bcrepeauac/nRF24L01_USB/README.md

# nRF24L01_USB
nRF24L01 adapter board for a computer.
