bcrepeauac/nRF24L01_USB/Rev -/Board Files/WirelessTransceiverUSB_Rev-.pdf

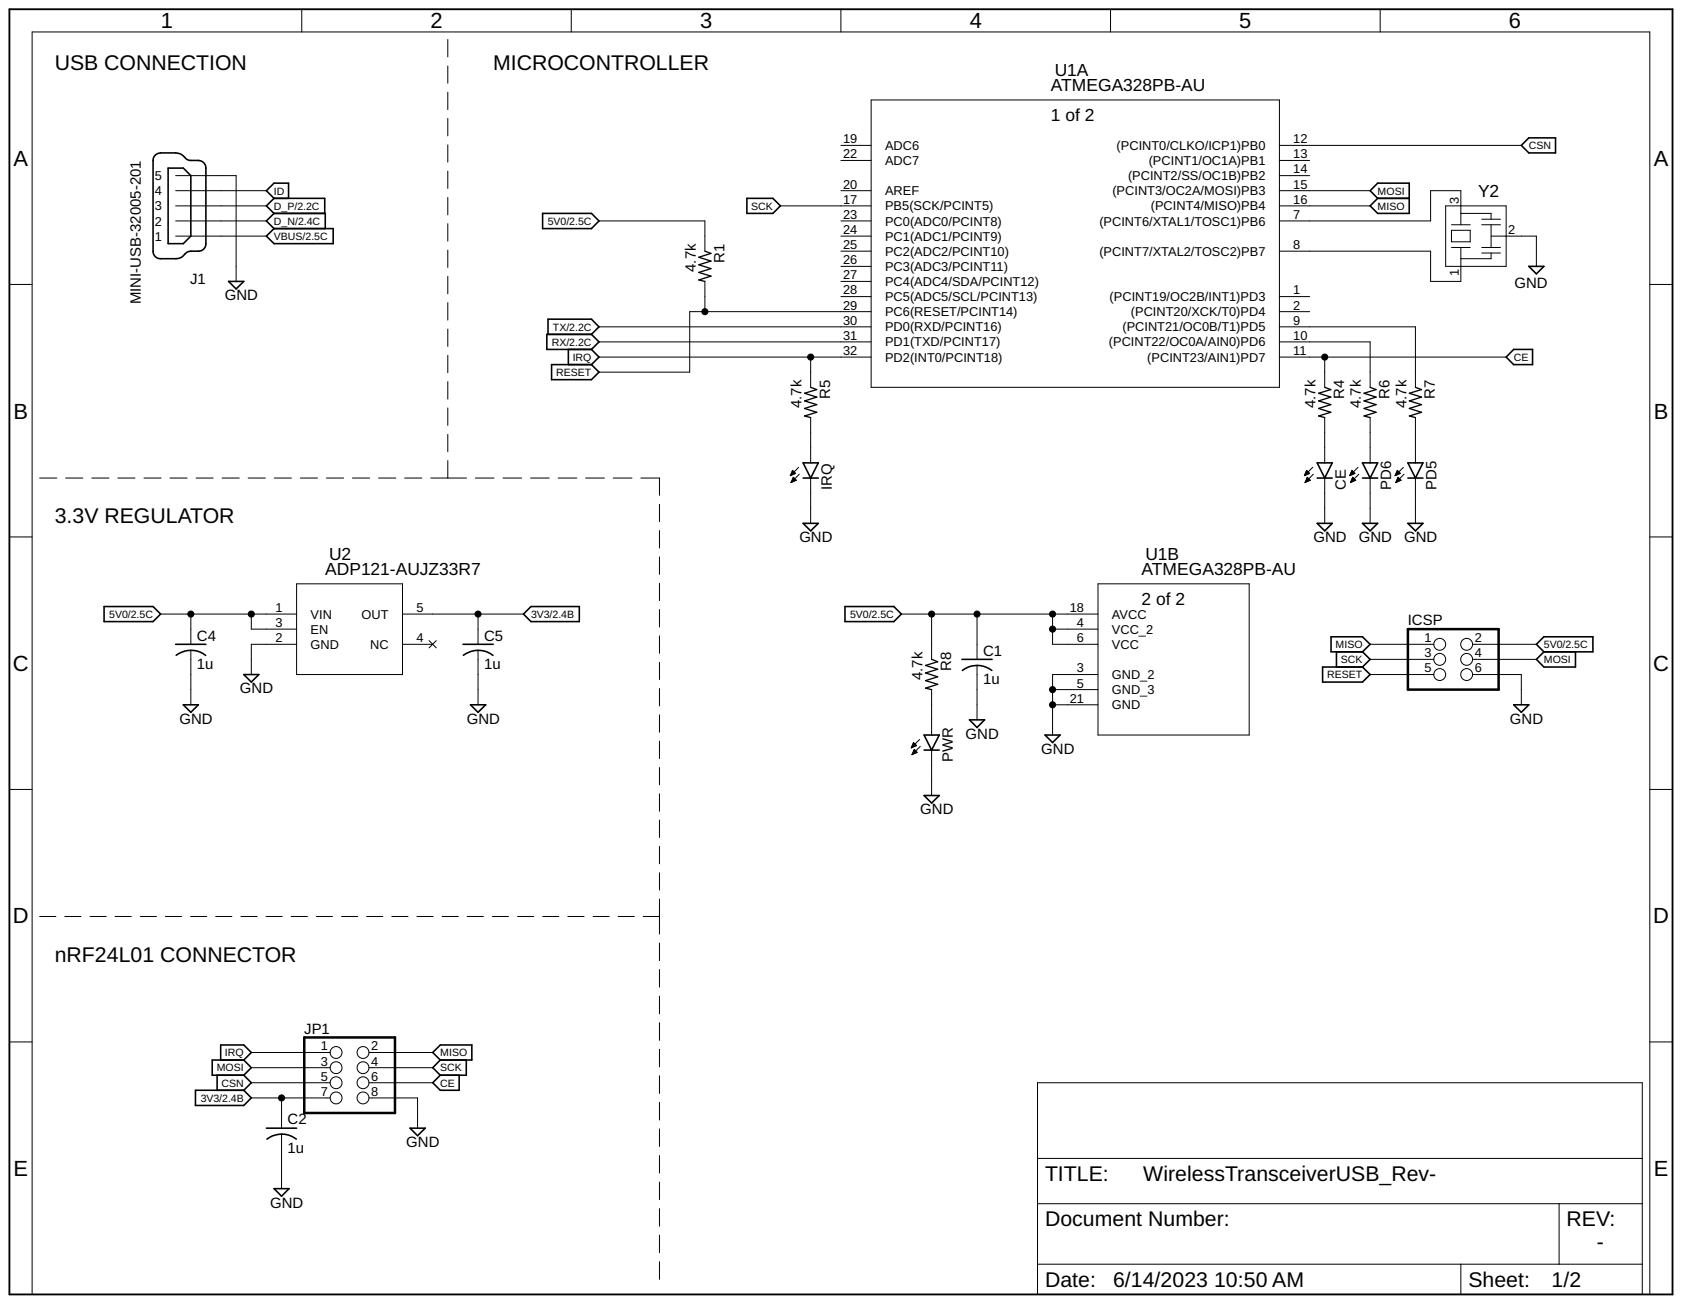
[picture p1: page 1]

ATMEGA328PB-AU

Document Number: | REV: -

Date: 6/14/2023 10:50 AM | Sheet: 1/2

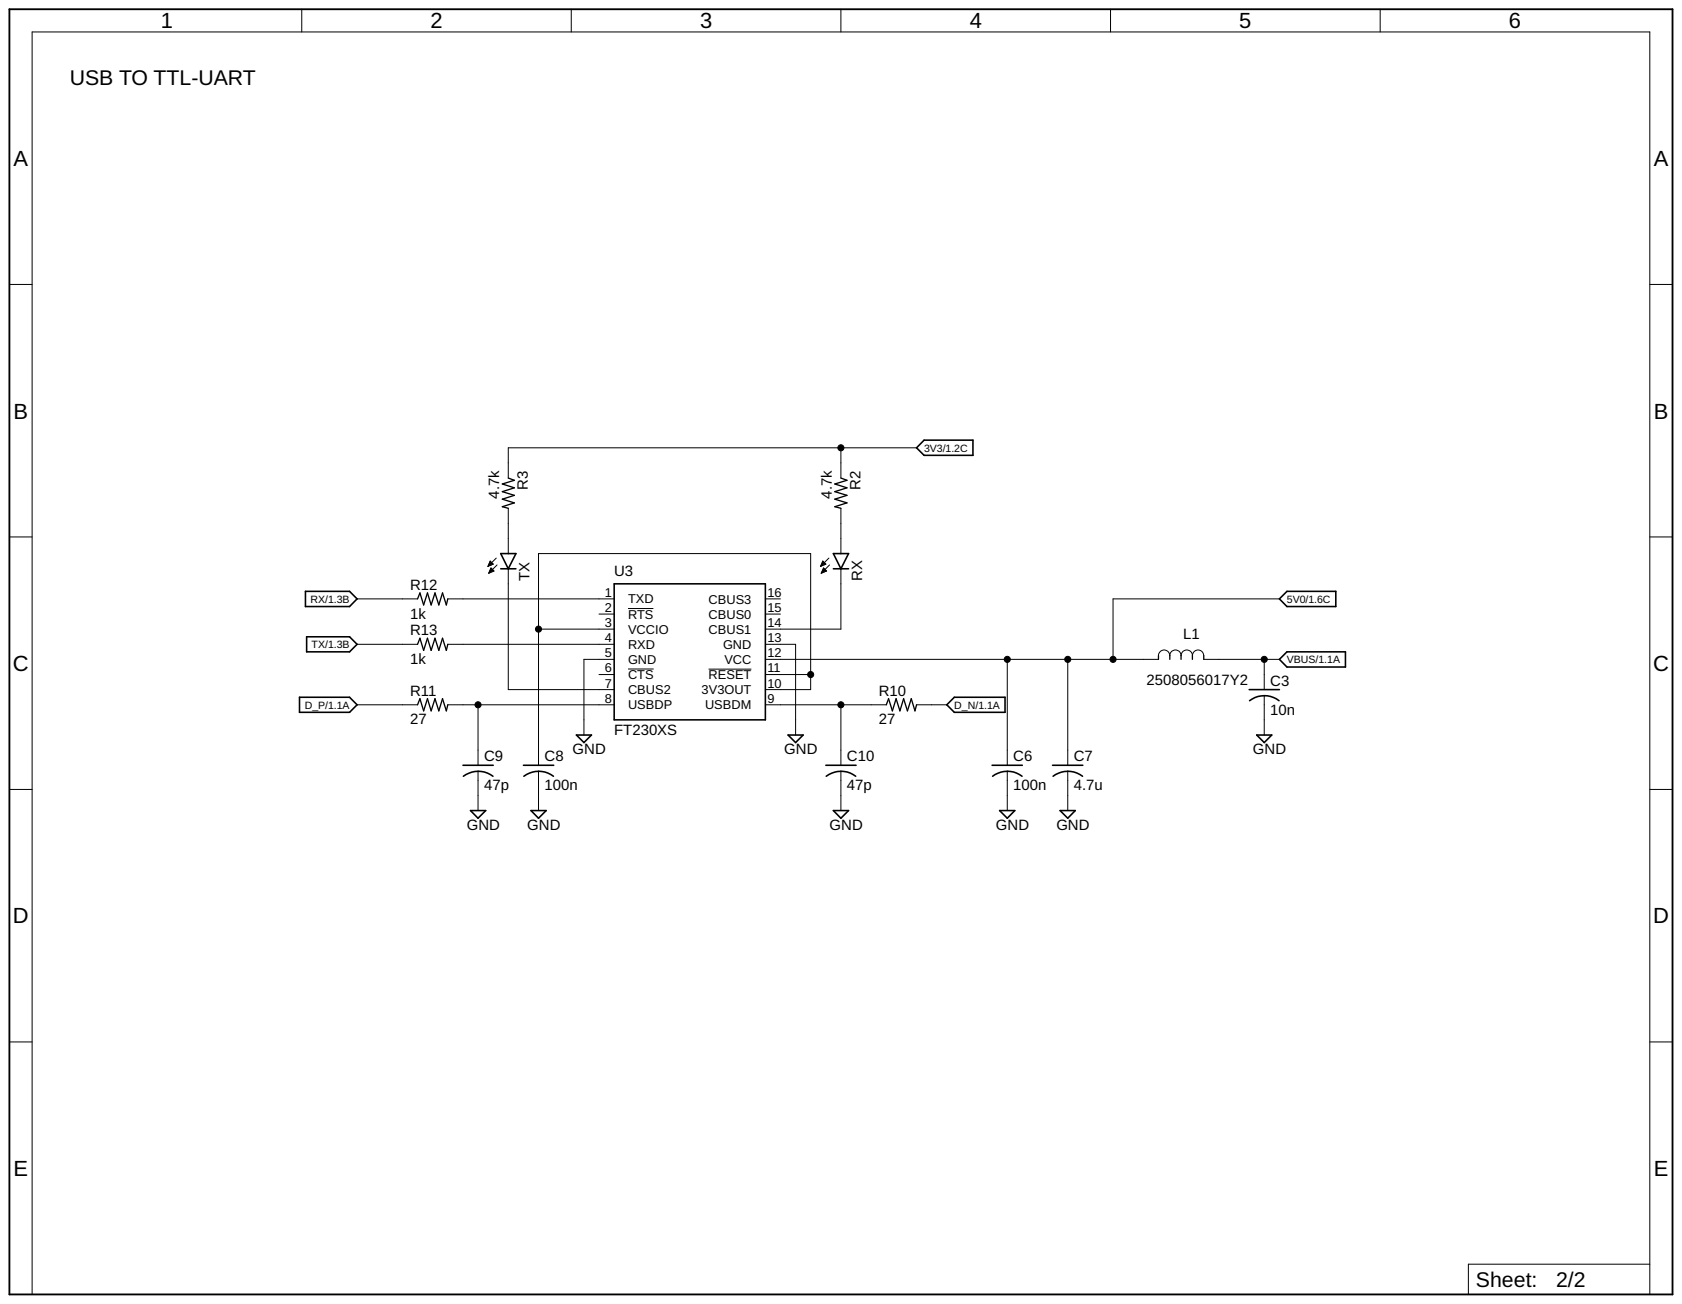
[picture p2: page 2]

USB TO TTL-UART
