bcrepeauac/nRF24L01_USB/Board Files/WirelessTransceiverUSB_RevA.pdf

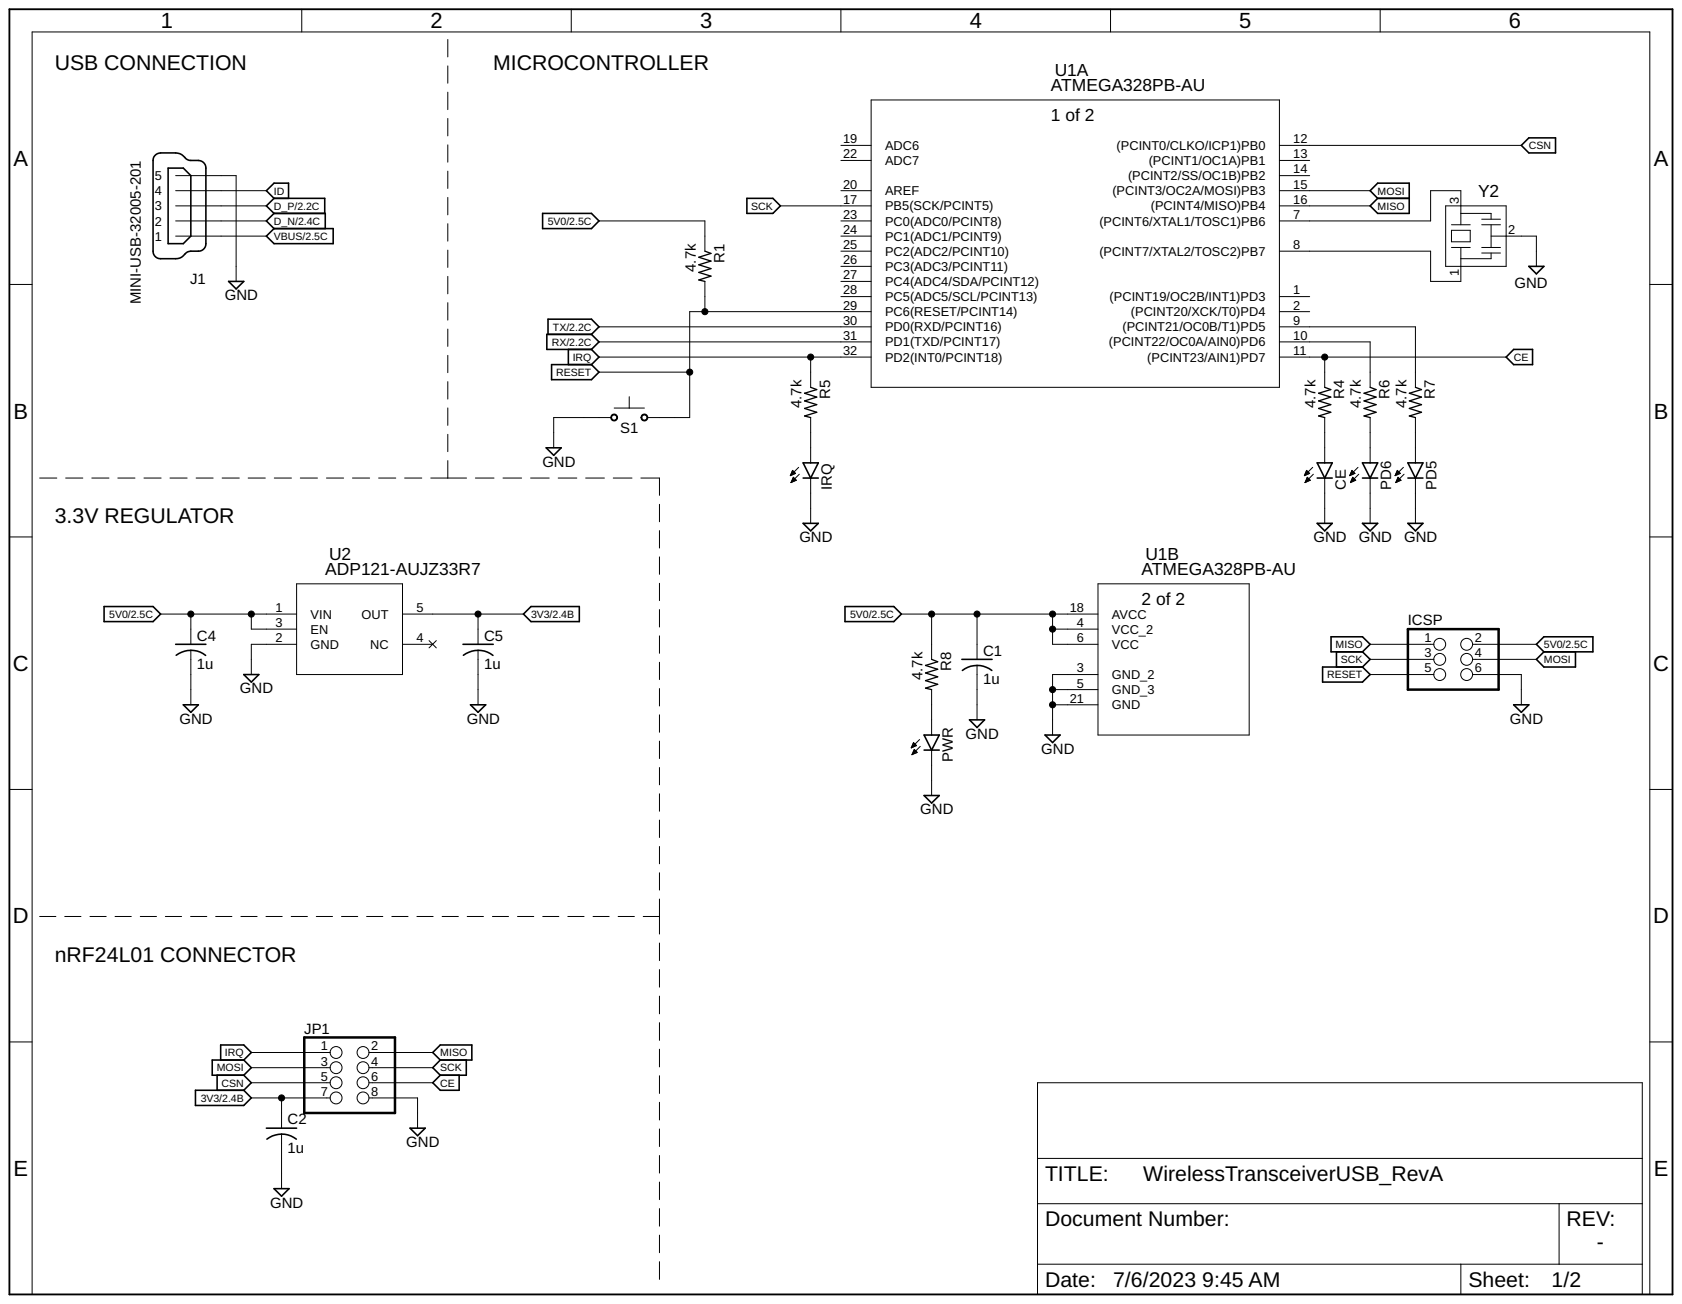
[picture p3: page 1]

ATMEGA328PB-AU

Document Number: | REV: -

Date: 7/6/2023 9:45 AM | Sheet: 1/2
