bcrepeauac/nRF24L01_USB/Board Files/WirelessTransceiverUSB_RevA.brd

## EAGLE design Board Files/WirelessTransceiverUSB_RevA.brd (2023-07-06)

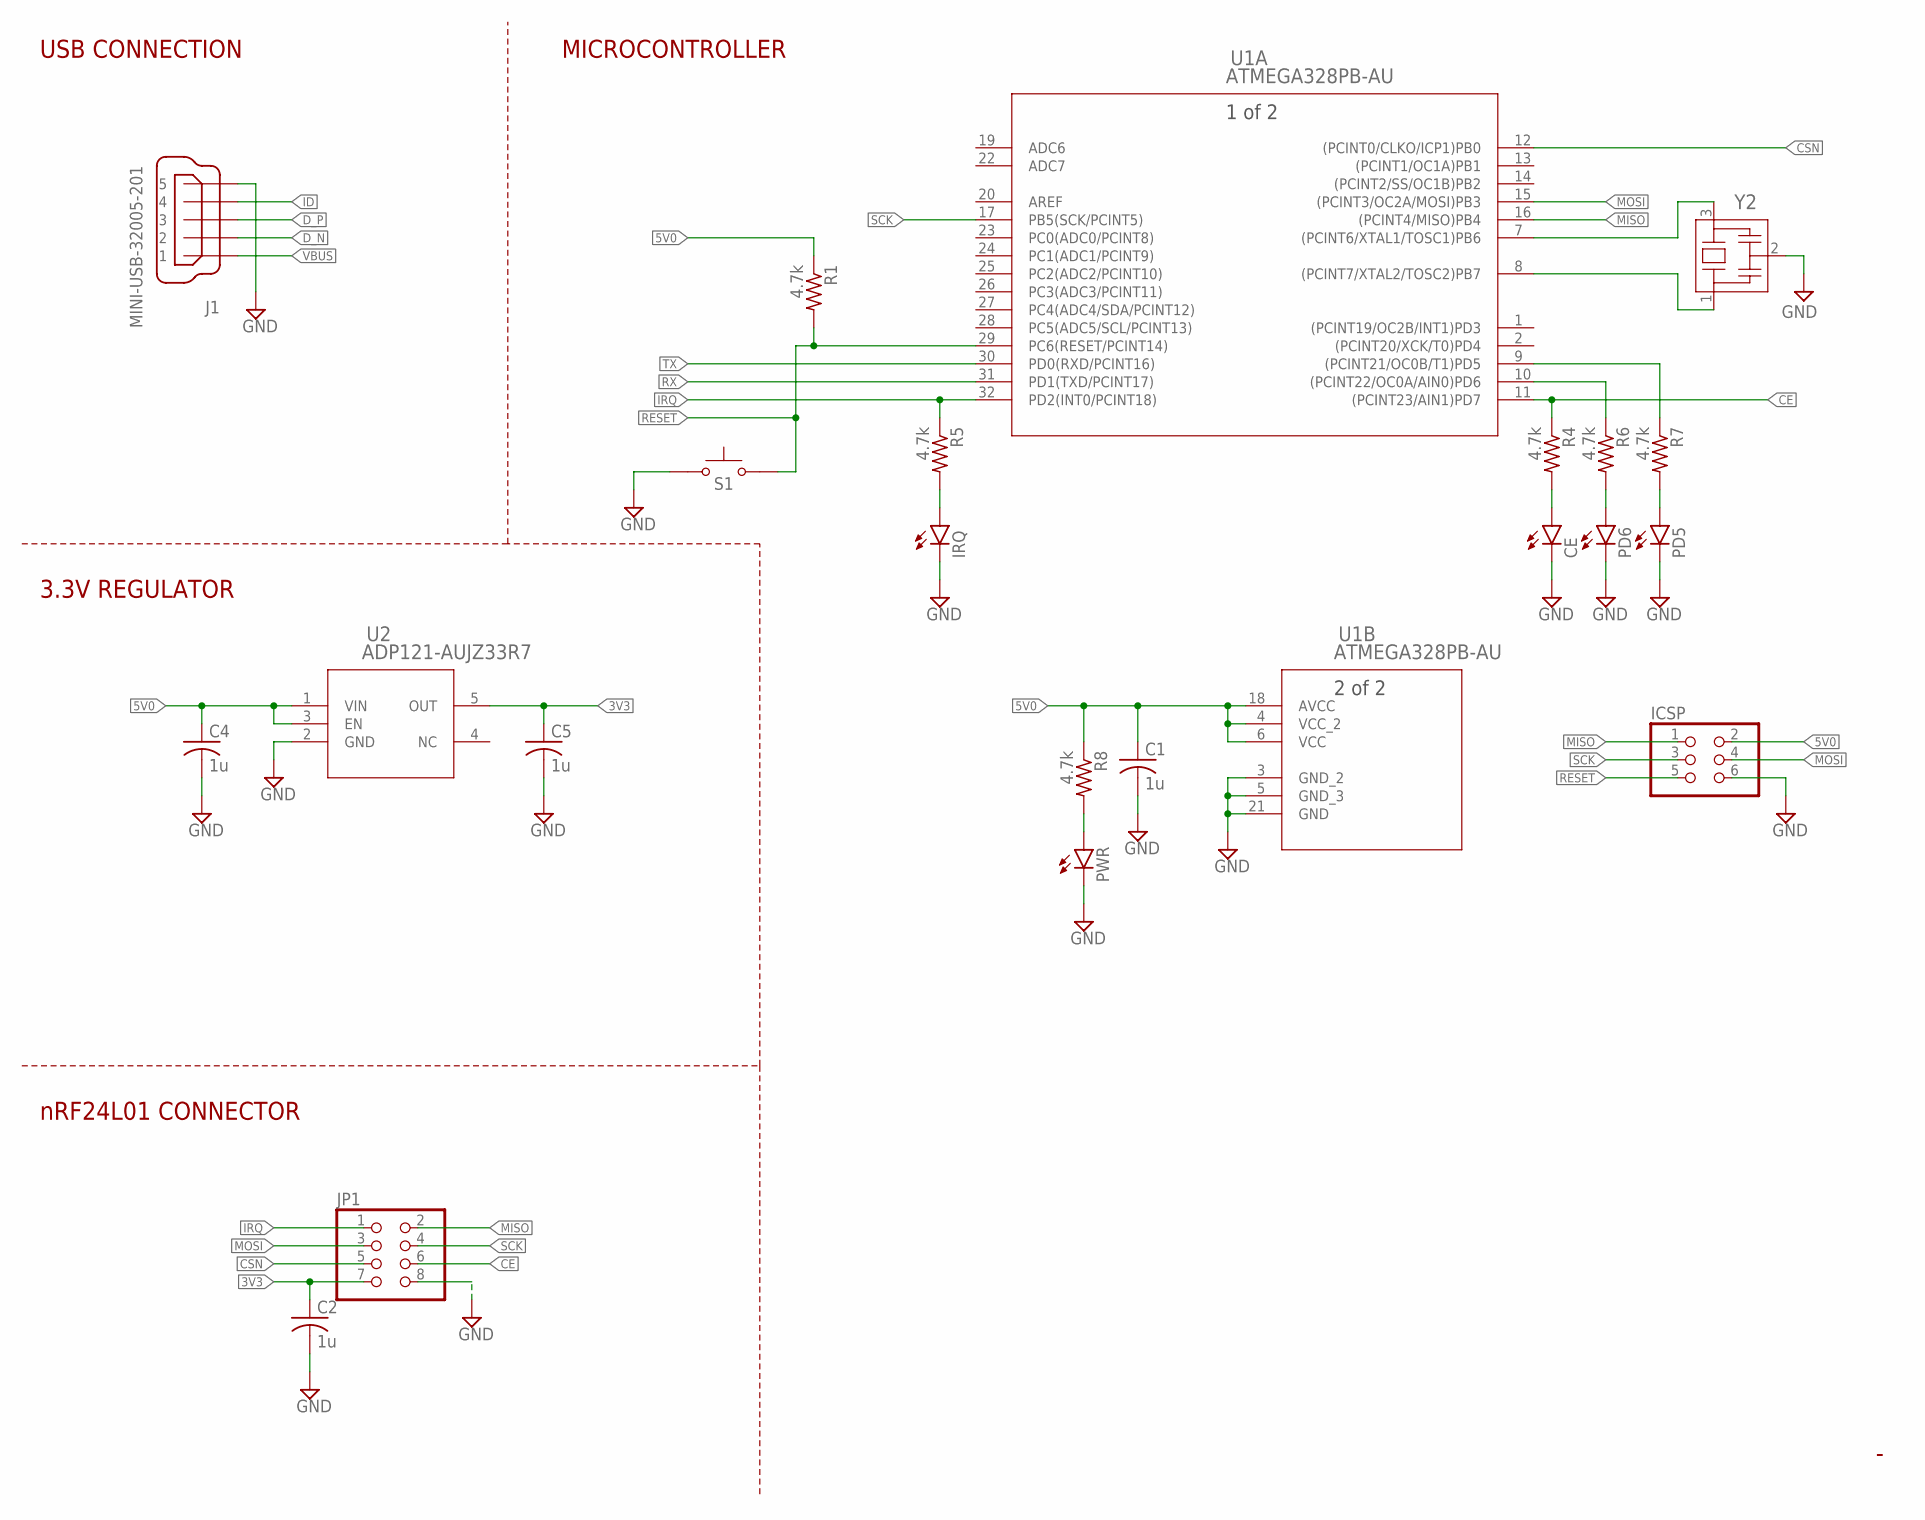
[picture p4: schematic WirelessTransceiverUSB_RevA.sch, sheet 1]

Parts:
C1, C2, C4, C5: 1u; C0805
CE: LEDSML0805; SML0805
ICSP: PINHD-2X3; 2X03
IRQ: LEDSML0805; SML0805
J1: MINI-USB-32005-201; 32005-201
JP1: PINHD-2X4; 2X04
PD5, PD6: LEDSML0805; SML0805
PWR: LEDSML0805; SML0805
R1, R4, R5, R6, R7, R8: 4.7k; R0805
S1: TL3315NF100Q; SW_TL3315NF100Q
U1: ATMEGA328PB-AU; 32A_MCH
U2: ADP121-AUJZ33R7; UJ_5_ADI
Y2: CSTNE16M0V530000R0; CSTNE16M0V530000R0_MUR

Connections:
3V3: C2.1, C5.1, JP1.7, U2.5 (OUT); also elsewhere on the board
5V0: C1.1, C4.1, ICSP.2, R1.1, R8.1, U1.4 (VCC_2), U1.6 (VCC), U1.18 (AVCC), U2.1 (VIN), U2.3 (EN); also elsewhere on the board
CE: JP1.6, R4.1, U1.11 ((PCINT23/AIN1)PD7)
CSN: JP1.5, U1.12 ((PCINT0/CLKO/ICP1)PB0)
D_N: J1.2; also elsewhere on the board
D_P: J1.3; also elsewhere on the board
GND: C1.2, C2.2, C4.2, C5.2, CE.C, ICSP.6, IRQ.C, J1.5, JP1.8, PD5.C, PD6.C, PWR.C, S1.1, S1.2 (1), U1.3 (GND_2), U1.5 (GND_3), U1.21 (GND), U2.2 (GND), Y2.2; also elsewhere on the board
ID: J1.4
IRQ: JP1.1, R5.1, U1.32 (PD2(INT0/PCINT18))
MISO: ICSP.1, JP1.2, U1.16 ((PCINT4/MISO)PB4)
MOSI: ICSP.4, JP1.3, U1.15 ((PCINT3/OC2A/MOSI)PB3)
unnamed: U1.7 ((PCINT6/XTAL1/TOSC1)PB6), Y2.3
unnamed: U1.8 ((PCINT7/XTAL2/TOSC2)PB7), Y2.1
unnamed: CE.A, R4.2
unnamed: IRQ.A, R5.2
unnamed: PD5.A, R7.2
unnamed: PD6.A, R6.2
unnamed: PWR.A, R8.2
PD5: R7.1, U1.9 ((PCINT21/OC0B/T1)PD5)
PD6: R6.1, U1.10 ((PCINT22/OC0A/AIN0)PD6)
RESET: ICSP.5, R1.2, S1.3, S1.4 (3), U1.29 (PC6(RESET/PCINT14))
RX: U1.31 (PD1(TXD/PCINT17)); also elsewhere on the board
SCK: ICSP.3, JP1.4, U1.17 (PB5(SCK/PCINT5))
TX: U1.30 (PD0(RXD/PCINT16)); also elsewhere on the board
VBUS: J1.1; also elsewhere on the board

Notes on the sheet:
USB CONNECTION
3.3V REGULATOR
nRF24L01 CONNECTOR
MICROCONTROLLER

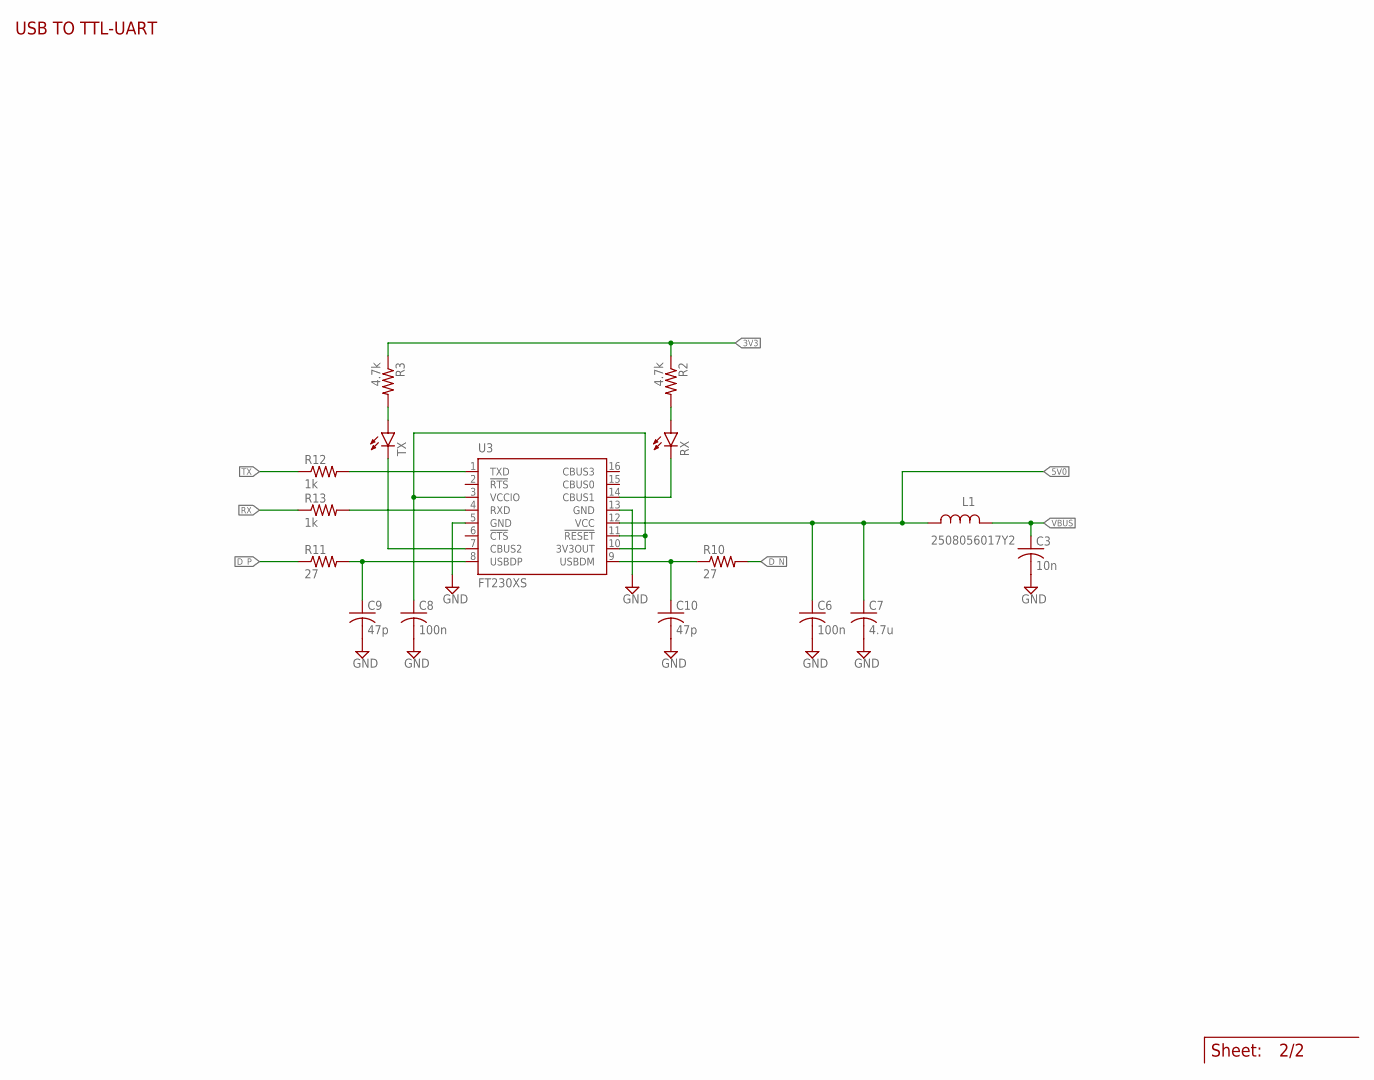
[picture p5: schematic WirelessTransceiverUSB_RevA.sch, sheet 2]

Parts:
C3: 10n; C0805
C6, C8: 100n; C0805
C7: 4.7u; C0805
C9, C10: 47p; C0603
L1: 2508056017Y2; IND_25_0805_FRT
R2, R3: 4.7k; R0805
R10, R11: 27; R0603
R12, R13: 1k; R0805
RX: LEDSML0805; SML0805
TX: LEDSML0805; SML0805
U3: FT230XS; SSOP16

Connections:
3V3: R2.1, R3.1; also elsewhere on the board
5V0: C6.1, C7.1, L1.2, U3.12 (VCC); also elsewhere on the board
D_N: R10.2; also elsewhere on the board
D_P: R11.1; also elsewhere on the board
GND: C3.2, C6.2, C7.2, C8.2, C9.2, C10.2, U3.5 (GND), U3.13 (GND); also elsewhere on the board
unnamed: R2.2, RX.A
unnamed: R3.2, TX.A
unnamed: C8.1, U3.3 (VCCIO), U3.10 (3V3OUT), U3.11 (!RESET)
unnamed: TX.C, U3.7 (CBUS2)
unnamed: RX.C, U3.14 (CBUS1)
unnamed: R12.2, U3.1 (TXD)
unnamed: R13.2, U3.4 (RXD)
RX: R13.1; also elsewhere on the board
TX: R12.1; also elsewhere on the board
USBD_N: C10.1, R10.1, U3.9 (USBDM)
USBD_P: C9.1, R11.2, U3.8 (USBDP)
VBUS: C3.1, L1.1; also elsewhere on the board

Notes on the sheet:
Sheet:
USB TO TTL-UART

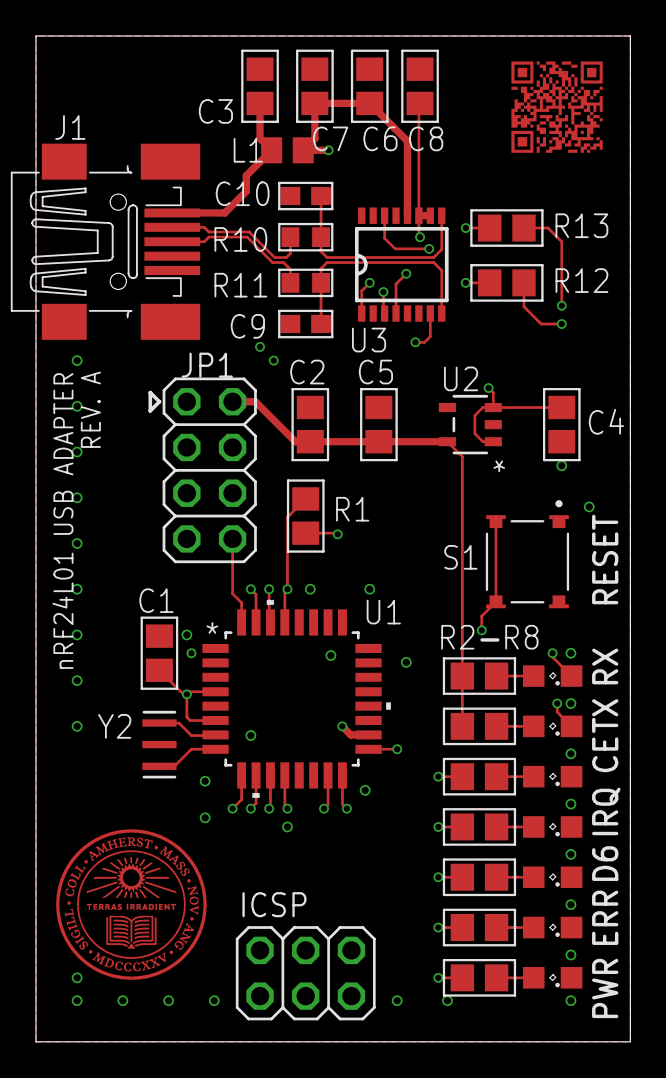
[picture p6: board WirelessTransceiverUSB_RevA.brd from above]

Board: 4 copper layers, 33.0 x 55.9 mm, 38 parts (0 on the bottom side), 33 nets.
