bcrepeauac/nRF24L01_USB/(commit log)

2023-06-14 Corrected .brd file
    [WirelessTransceiverUSB_Rev-.brd]
2023-07-06 Updated to Rev A
    Corrected TX/RX error in board layout and added reset button.
    [WirelessTransceiverUSB_Rev-.brd, WirelessTransceiverUSB_Rev-.csv, WirelessTransceiverUSB_Rev-.sch, WirelessTransceiverUSB_RevA.brd, WirelessTransceiverUSB_RevA.csv, WirelessTransceiverUSB_RevA.sch]
