bcrepeauac/nRF24L01_USB/(notices)

Notices in the files:
parts and their libraries:
linear: COPYRIGHT: Copyright (C) 2023 Ultra Librarian. All rights reserved.
